SainsburyWellcomeCentre/fablab-kicad-library/docs/images/configure-paths.png

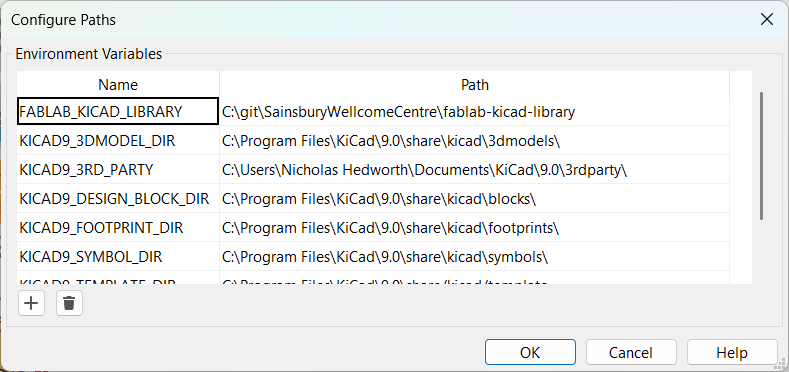
docs/images/configure-paths.png
