SainsburyWellcomeCentre/fablab-kicad-library/docs/images/design-blocks-library.png

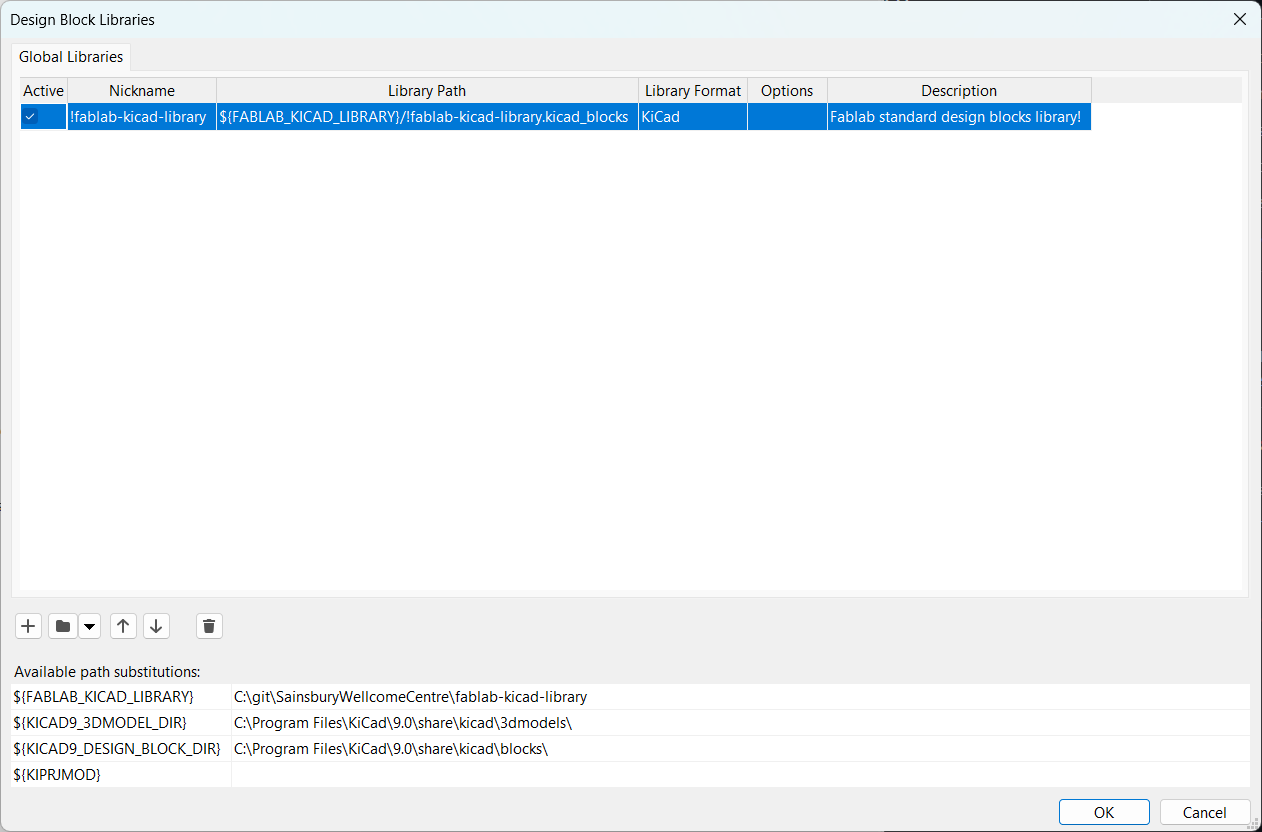
docs/images/design-blocks-library.png
