SainsburyWellcomeCentre/fablab-kicad-library/docs/images/footprint-library.png

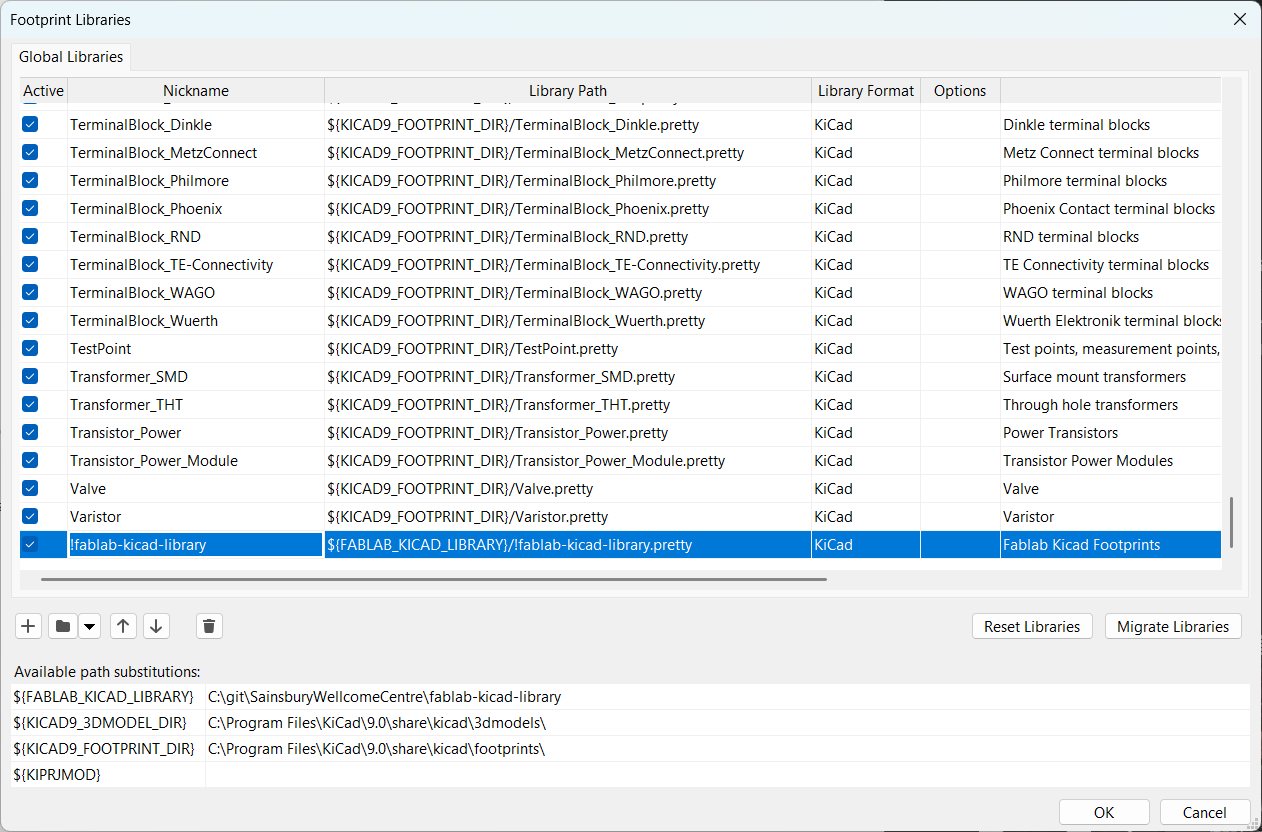
docs/images/footprint-library.png
