SainsburyWellcomeCentre/fablab-kicad-library/docs/images/kicad-open.png

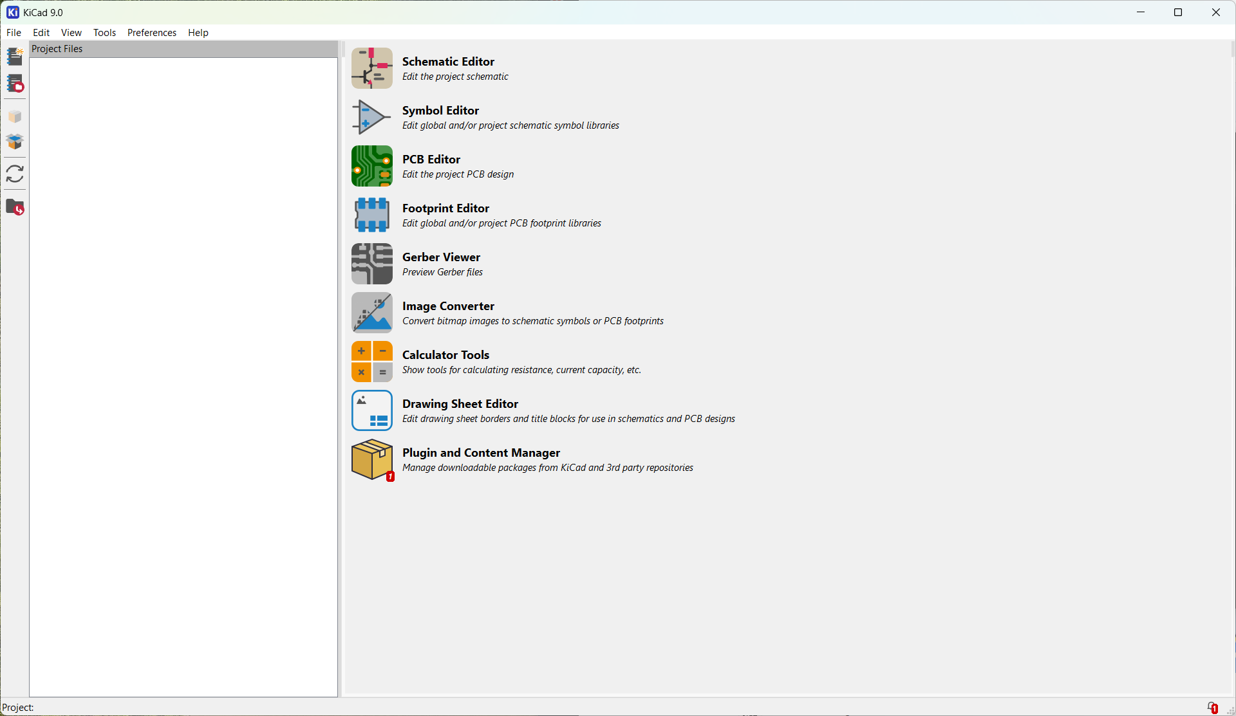
docs/images/kicad-open.png
