SainsburyWellcomeCentre/fablab-kicad-library/docs/images/library-quick-access.png

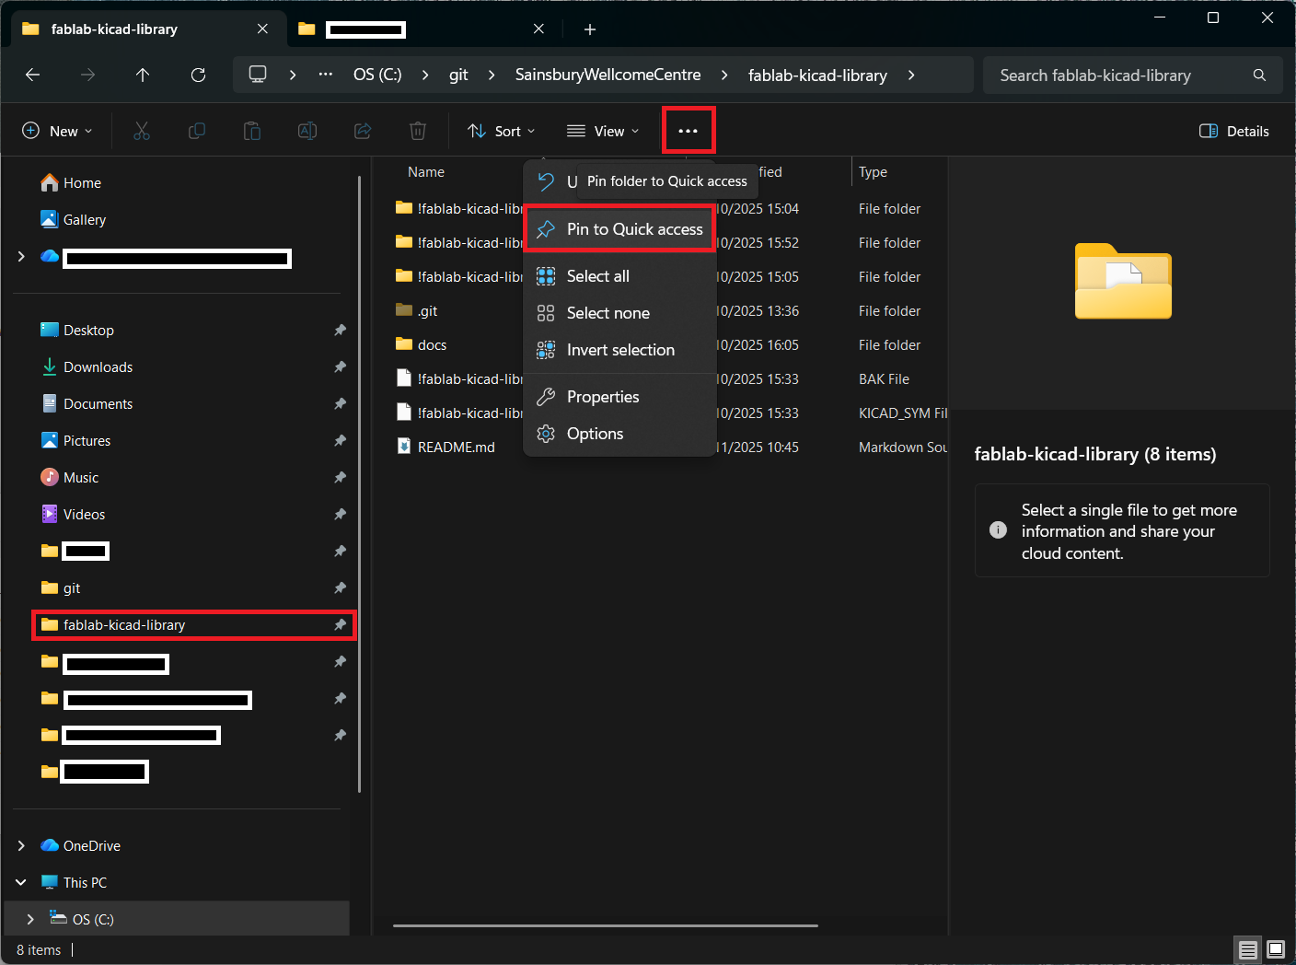
docs/images/library-quick-access.png
