SainsburyWellcomeCentre/fablab-kicad-library/docs/images/select-symbol-library.png

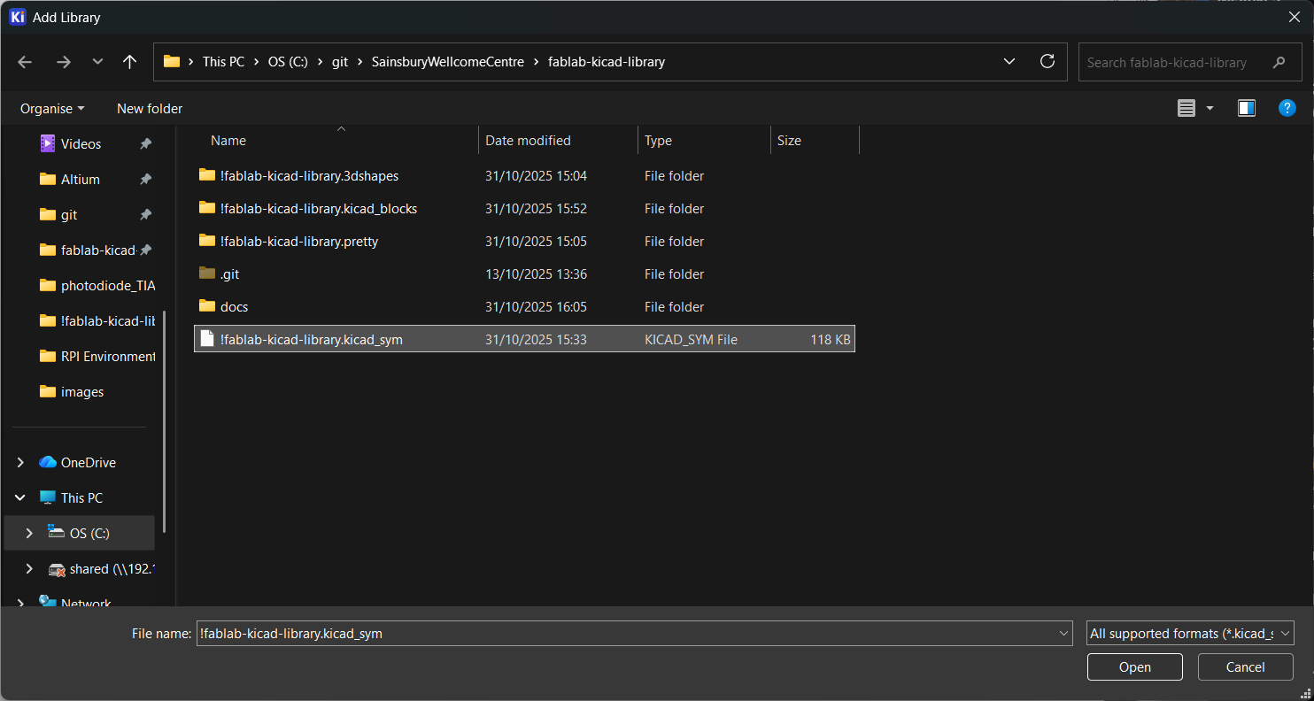
docs/images/select-symbol-library.png
