SainsburyWellcomeCentre/fablab-kicad-library/docs/images/symbol-library.png

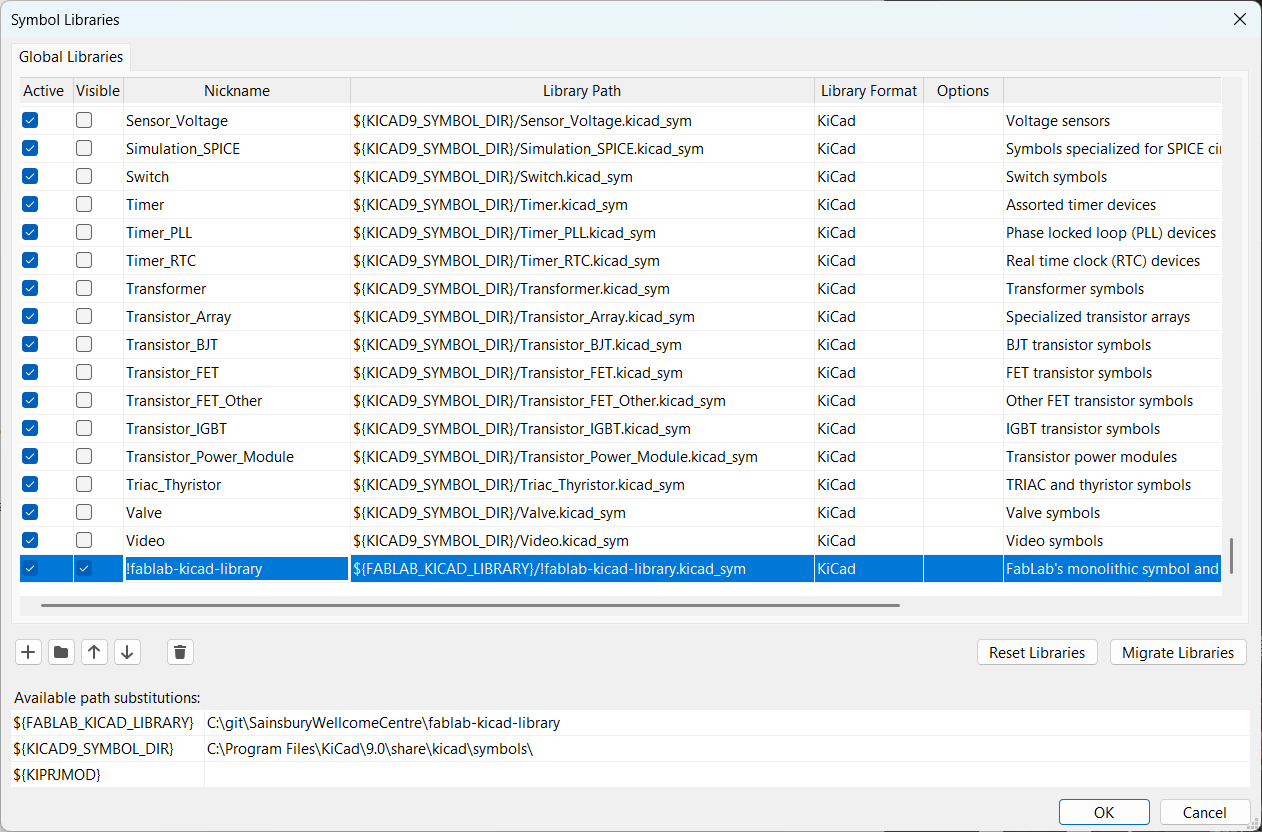
docs/images/symbol-library.png
