SainsburyWellcomeCentre/fablab-kicad-library/docs/images/terminal.png

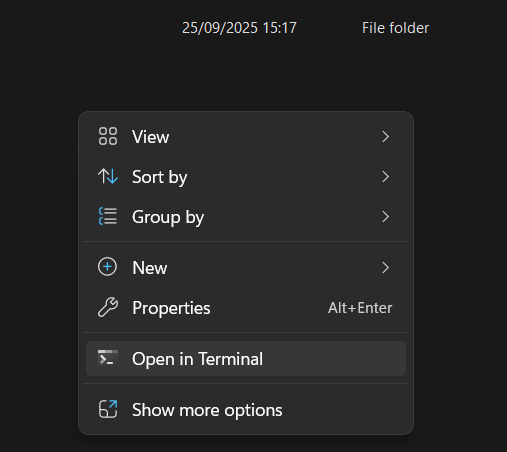
docs/images/terminal.png
