SainsburyWellcomeCentre/fablab-kicad-library/!fablabs-kicad-library.kicad_blocks/DC-DC, Buck, 6V out, 12V-24V in.kicad_block/DC-DC, Buck, 6V out, 12V-24V in.kicad_sch

## KiCad design !fablabs-kicad-library.kicad_blocks/DC-DC, Buck, 6V out, 12V-24V in.kicad_block/DC-DC, Buck, 6V out, 12V-24V in.kicad_sch (2025-11-14)

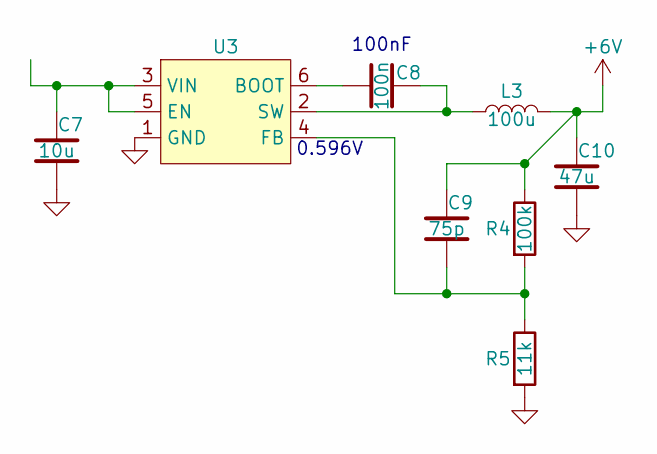
[picture p9: schematic DC-DC, Buck, 6V out, 12V-24V in.kicad_sch]

Parts:
C7: 10u; C_0805_2012M; Part Version 0.0.0; JLCPCB Part # C440198
C8: 100n; C_0402_1005M; Part Version 0.0.0; JLCPCB Part # C77020
C9: 75p; C_0402_1005M; Part Version 0.0.0; JLCPCB Part # C162121
C10: 47u; C_0805_2012M; Part Version 0.0.0; JLCPCB Part # C124129
L3: 100u; VLCF4020T-101MR26; Part Version 0.0.0; JLCPCB Part # C20339
R4: 100k; R_0402_1005M; Part Version 0.0.0; JLCPCB Part # C25741
R5: 11k; R_0402_1005M; Part Version 0.0.0; JLCPCB Part # C25749
U3: TPS54302DDCR; TSOT-23-6; Part Version 0.0.0; JLCPCB Part # C311983

Connections:
+6V: C9.2, C10.2, L3.2, R4.2
GND: C7.1, C10.1, R5.1, U3.1 (GND)
unnamed: C7.2, U3.3 (VIN), U3.5 (EN)
unnamed: C8.1, U3.6 (BOOT)
unnamed: C8.2, L3.1, U3.2 (SW)
unnamed: C9.1, R4.1, R5.2, U3.4 (FB)

Notes on the sheet:
100nF
0.596V
