SainsburyWellcomeCentre/fablab-kicad-library/!fablabs-kicad-library.kicad_blocks/DC-DC, LDO, 5V out.kicad_block/DC-DC, LDO, 5V out.kicad_sch

## KiCad design !fablabs-kicad-library.kicad_blocks/DC-DC, LDO, 5V out.kicad_block/DC-DC, LDO, 5V out.kicad_sch (2025-11-14)

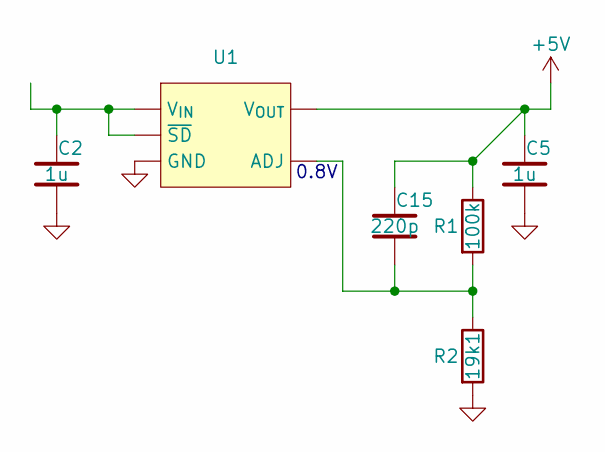
[picture p10: schematic DC-DC, LDO, 5V out.kicad_sch]

Parts:
C2, C5: 1u; C_0402_1005M; MFR.Part # CL05A105KA5NQNC; JLCPCB Part # C52923
C15: 220p; C_0402_1005M; Part Version 0.0.0; JLCPCB Part # C71693
R1: 100k; R_0402_1005M; Part Version 0.0.0; JLCPCB Part # C25741
R2: 19k1; R_0402_1005M; Part Version 0.0.0; JLCPCB Part # C2998158
U1: AP2127K-ADJTRG1; SOT-23-5; Part Version 0.0.0; JLCPCB Part # C96343

Connections:
+5V: C5.2, C15.2, R1.2, U1.5 (V_{OUT})
GND: C2.1, C5.1, R2.1, U1.2 (GND)
unnamed: C2.2, U1.1 (V_{IN}), U1.3 (~SD)
unnamed: C15.1, R1.1, R2.2, U1.4 (ADJ)

Notes on the sheet:
0.8V
