SainsburyWellcomeCentre/fablab-kicad-library/(commit log)

2025-11-04 Added footprint TSOT-23-6
2025-11-05 Added footprint VLCF4020T-101MR26
2025-11-05 Added basic power symbols GND, +V, -V
2025-11-14 Added many parts, symbols, footprints and designblocks.... sorry
    [DC-DC, Buck, 6V out, 12V-24V in.kicad_sch, DC-DC, LDO, 5V out.kicad_sch]
